Aragya1642/ElevatorRedo/(commit log)

2024-04-19 Keypad + button + door functionality
2024-06-08 PCB Image Upload
